ret2binsh/TalkingD20/assets/d20_1.jpg

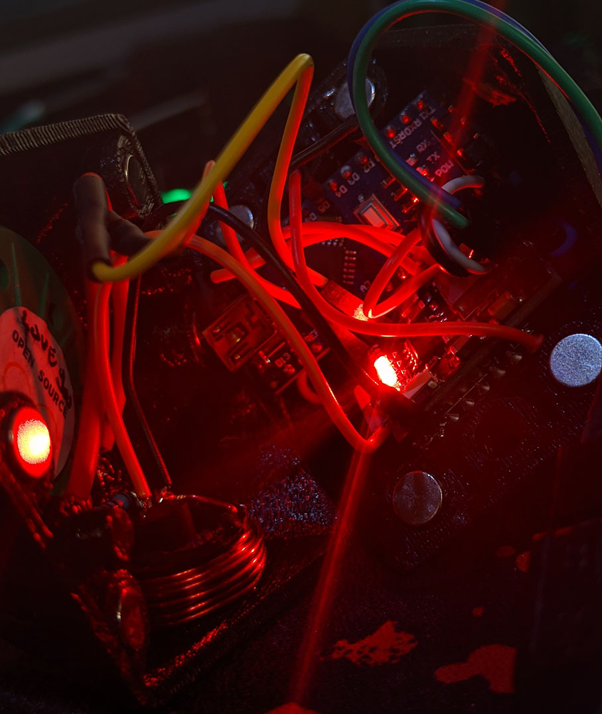
assets/d20_1.jpg
