ret2binsh/TalkingD20/assets/d20_2.jpg

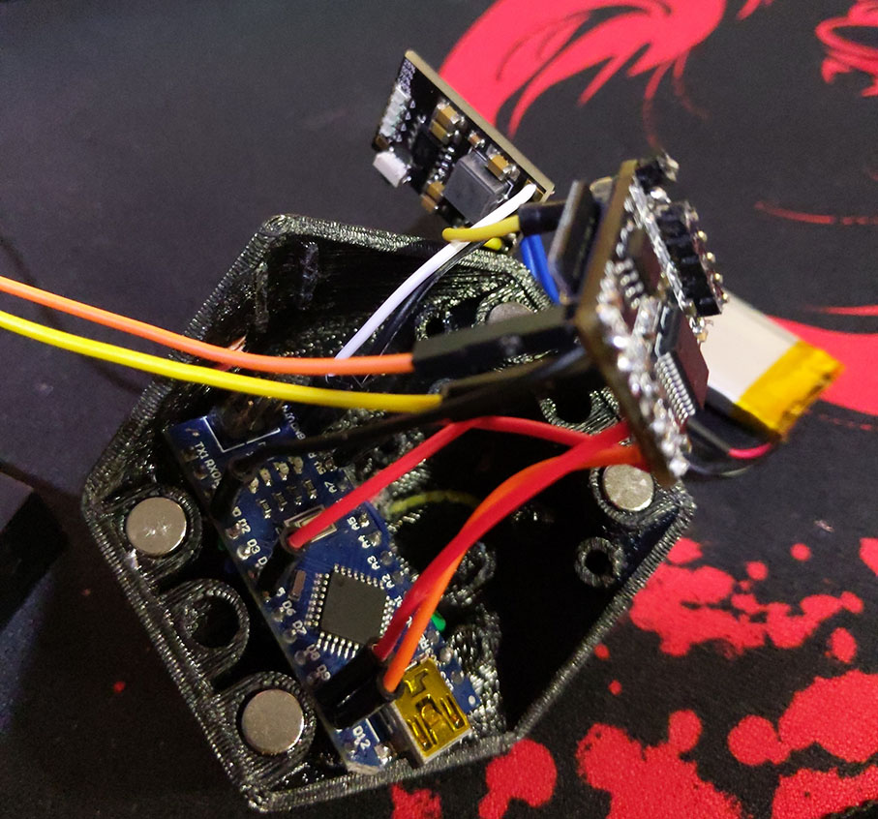
assets/d20_2.jpg
