ret2binsh/TalkingD20/assets/D20_CoilPad.jpg

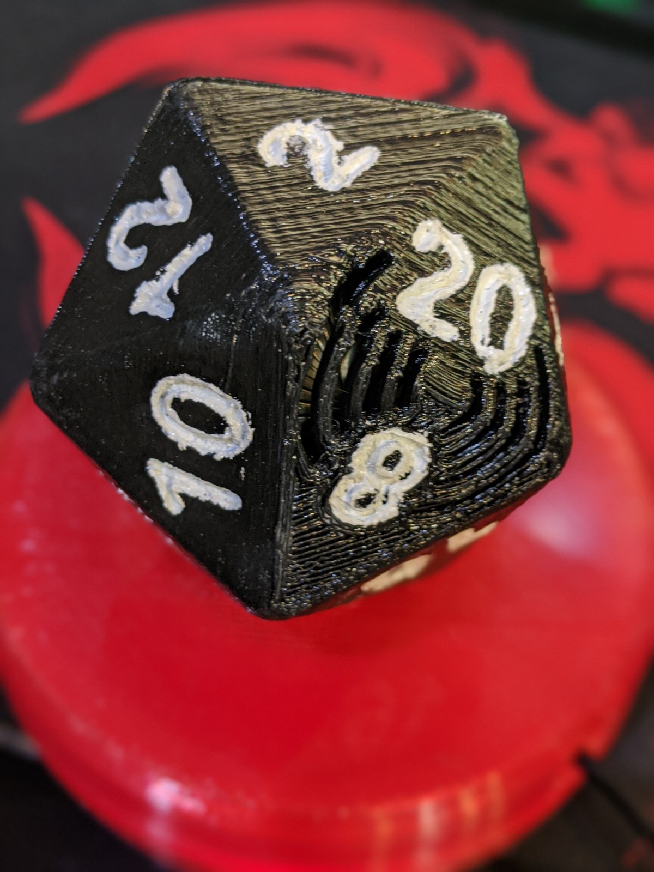
assets/D20_CoilPad.jpg
