ret2binsh/TalkingD20/assets/D20_Spin.jpg

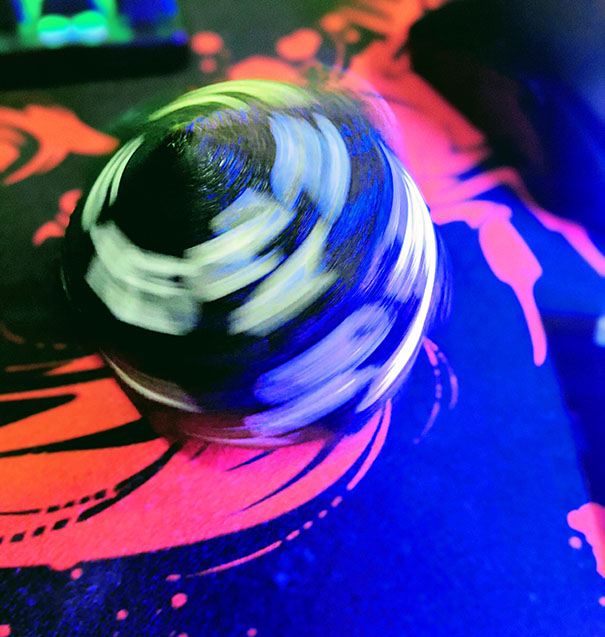
assets/D20_Spin.jpg
