ret2binsh/TalkingD20/(commit log)

2020-04-06 Fixed indexing error within the #1 Face tracks.
    [D20_Die.ino]
2020-04-06 Added additional mp3s to device and updated code accordingly.
