ret2binsh/TalkingD20/(notices)

Notices in the files:
README.md:
License: GPL v3
